hectorcs23/screen-luminance-robot-arm/docs/img/hysteresis.png

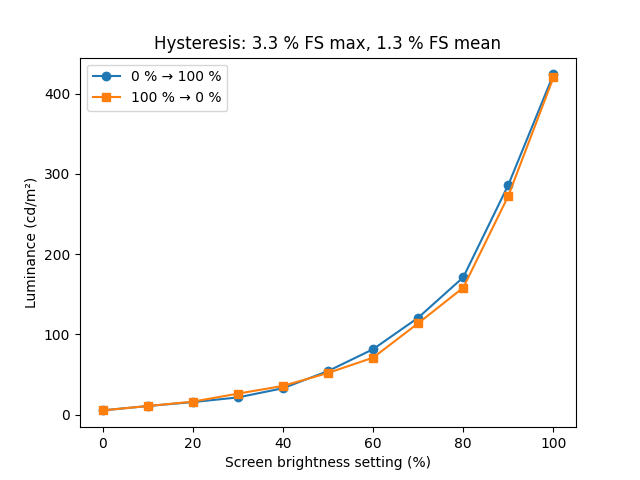
docs/img/hysteresis.png
