hectorcs23/screen-luminance-robot-arm/docs/img/led_reference.png

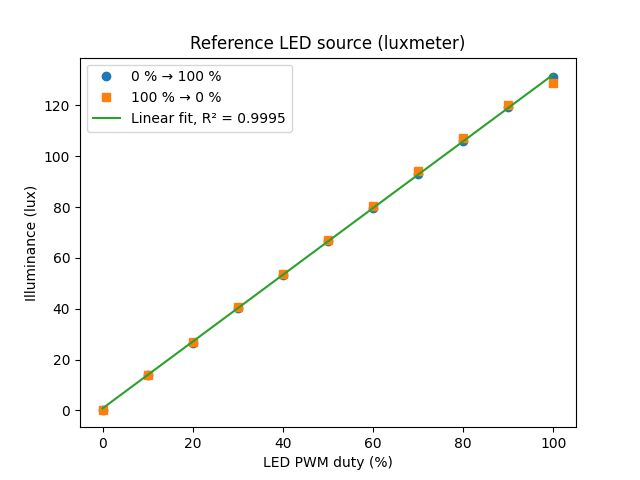
docs/img/led_reference.png
