hectorcs23/screen-luminance-robot-arm/results/discarded_samples.csv

burst_id | sample_idx | brightness | lux | als_raw
5 | 0 | 40 | 346033.875 | 9
11 | 0 | 100 | 346033.875 | 46
12 | 0 | 100 | 346033.875 | 73
