hectorcs23/screen-luminance-robot-arm/docs/img/characterization.png

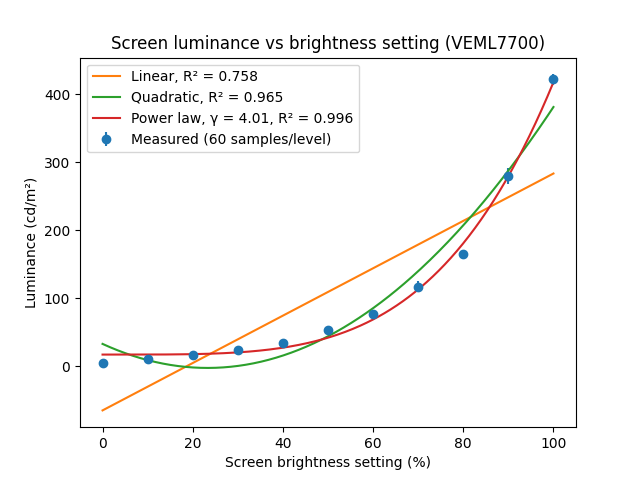
docs/img/characterization.png
