hectorcs23/screen-luminance-robot-arm/docs/img/cross_calibration.png

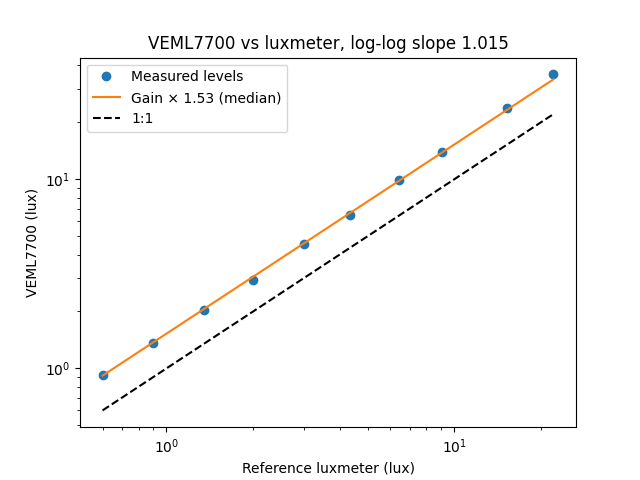
docs/img/cross_calibration.png
