hectorcs23/screen-luminance-robot-arm/(commit log)

2026-09-21 docs: add CAD model of the structure and 3D view of the PCB
2026-09-21 Update README to remove images and clarify findings
    Removed images from the characterization section and clarified the findings on sensor error and hysteresis.
